GunayAnach/ESP32_ReflowOvenController/(commit log)

2019-05-27 removed unused files ...
    [ReflowController.brd, ReflowController.sch, bom.csv]
2019-06-11 ESP32 gogogo
2019-06-15 More Bug fixing and less agressive PID Tuning
    [ReflowController.ino]
